LeoRibeiro01/sentinela/docs/DECISOES.md

# Registro de decisões técnicas

Cada decisão: o que foi decidido e por quê. Mais recentes no fim.

## Fases 0 e 1 — ambiente e firmware

- **Arduino CLI portátil em `.tools/`** (1.5.1, ignorado pelo Git) com core `esp32:esp32` **2.0.17** e FQBN `esp32:esp32:esp32`. O `winget` encontrou o pacote, mas não concluiu a instalação; a versão portátil evita depender de PATH/admin. Em outra máquina, basta seguir o README.
- **Rede em modo Access Point** fixo (`SENTINELA` / `sentinela123` / `192.168.4.1`), canal 6, até 4 clientes, `WiFi.setSleep(false)` e `WiFi.persistent(false)` (não grava configuração na flash a cada boot). Redes de faculdade costumam isolar dispositivos; o AP elimina essa dependência e funciona sem internet.
- **Firmware dividido em 3 arquivos**: `captura_audio.*` (amostragem), `atuadores.*` (pinos e modo auto) e `esp32_server.ino` (Wi-Fi e rotas). Um arquivo = uma responsabilidade, o que facilita a explicação na defesa.
- **Amostragem: timer de hardware + tarefa FreeRTOS no núcleo 1** (primeira opção do plano do projeto). O timer 0 usa divisor 40 (2 MHz) e alarme de 125 ticks, ou seja, **16 000 Hz exatos**. A versão anterior usava 62 µs, o que dava 16 129 Hz. A interrupção só notifica a tarefa, porque `adc1_get_raw` usa travas que não podem ser chamadas dentro de uma ISR. A tarefa tem prioridade 3 no núcleo 1 (o `loop()` tem prioridade 1); a pilha Wi-Fi fica no núcleo 0. O ADC contínuo por DMA (I2S-ADC) **não** foi adotado por causa dos relatos de leituras zeradas com Wi-Fi.
- **Medição de estabilidade**: a tarefa conta ticks perdidos (notificações acumuladas) e o maior intervalo entre amostras por segundo. Os valores aparecem em `/status` (`amostras_perdidas`, `intervalo_max_us`) e no log serial. Assim, taxa real e jitter são medidos, e não supostos.
- **Remoção de DC com média móvel em `float`** (α = 1/1024, corte de ~2,5 Hz). O filtro anterior era inteiro (`media += (x - media) >> 8`) e tem uma "zona morta" de até 255 contagens: o DC estimado parava longe do real e o resíduo inflava o RMS. Em simulação de silêncio, o RMS saía 32 em vez de 8. O ESP32 tem FPU de precisão simples, então o `float` é barato.
- **ADC1_CH6 (GPIO34), 12 bits, atenuação máxima.** No core 2.0.17 a constante `ADC_ATTEN_DB_11` está obsoleta e é idêntica a `ADC_ATTEN_DB_12`; usamos a nova para compilar sem avisos.
- **Buffer circular estático de 32 768 amostras PCM16 (64 KB, ~2,05 s).** É o limite de memória definido para a placa sem PSRAM. Por isso `/audio.wav` aceita `ms` de 200 a 2000.
- **WAV enviado em blocos de 512 bytes** com a API do `WebServer` (`setContentLength` + `sendContent`), sem copiar o trecho inteiro para a RAM. Limitação conhecida: com `ms=2000` sobram só ~48 ms de folga antes de a captura sobrescrever o início do trecho. Isso só corrompe o começo do WAV se o Wi-Fi travar o envio por mais de 48 ms logo no início. A IA usa `ms=1000` (folga de ~1 s).
- **Taxa no cabeçalho WAV = taxa medida** (`fs_real_hz`), como pede o contrato; antes da primeira medição usa 16 000.
- **Atuadores alterados só pelo `loop()`**. O modo `auto` passou da tarefa de áudio para o `loop()`, que avalia cada janela nova de 250 ms. Antes, a tarefa de áudio e os handlers HTTP mexiam no mesmo estado ao mesmo tempo (condição de corrida).
- **Modo auto com histerese**: alerta após 3 janelas acima do limiar (~0,75 s); volta a normal após 8 janelas abaixo (~2 s). Sem isso, o alerta e o buzzer piscariam a cada palavra.
- **`teste`**: sequência de 2 s (verde, vermelho, verde, vermelho, beep de 0,5 s, pausa) e depois **volta ao estado anterior**, para não atrapalhar uma demonstração em andamento.
- **Campos extras** (além do contrato, sem remover nenhum): `/status` ganhou `limiar`, `heap_minimo`, `amostras_perdidas`, `intervalo_max_us` e `clientes_wifi`; `/sensor` ganhou `adc_min`/`adc_max`, que mostram diretamente se o ADC está lendo zero com o Wi-Fi ligado (o teste crítico). A resposta de `/atuador` é `{"ok":true,"atuador":{...}}`, o mesmo objeto de `/status`.
- **`nivel`** é uma escala relativa: RMS 600 contagens = 100. Não é dB SPL. Pode ser recalibrado depois de medir silêncio e motor na placa.
- **Teste automatizado da Fase 1 em Python puro** (`tools/teste_fase1.py`, só biblioteca padrão), em vez de dezenas de `curl.exe` manuais: o resultado é objetivo ([OK]/[FALHA]) e repetível na segunda-feira.

## Fase 2 — dashboard e simulador

- **Dashboard em JS puro** (`index.html`/`app.js`/`style.css`), sem framework, CDN ou build. Abre por duplo clique (`file://`) ou servido pela IA em `localhost:5000`. Gráficos em `<canvas>` desenhados à mão, com FFT radix-2 própria para o espectro.
- **Polling sequencial** (`/status` e depois `/sensor`, a cada 1 s), porque o `WebServer` do ESP32 atende um cliente por vez. Timeout de 2 s com `AbortController`. **Duas falhas seguidas** mostram DESCONECTADO (uma só causaria pisca-pisca por perda de pacote). O laço nunca para, então a reconexão é automática.
- O áudio (forma de onda/espectro) só é baixado **sob demanda** ou a cada 5 s, se marcado, para não disputar o ESP32 com o serviço de IA.
- Endereço do ESP32: `?esp32=` na URL > `localStorage` > `192.168.4.1`. Ao mudar, o dashboard avisa o serviço de IA (`/api/config?esp32=`).
- Dados da rede entram na página só por `textContent`, nunca `innerHTML`.
- Visual para projetor: fundo escuro, fontes grandes, estado sempre em **texto e cor**.
- **Simulador `tools/mock_esp32.py`** (só biblioteca padrão), com a mesma API, as mesmas validações e a mesma lógica do atuador e do modo auto do firmware. Pode tocar WAVs reais (`--wav-dir`, `--padrao`) para testar a IA de ponta a ponta sem placa. Passa em 100% do `teste_fase1.py rotas`.

## Fase 3 — IA

- **YAMNet + regressão logística** (scikit-learn) sobre os embeddings de 1024 dimensões. Modelo pequeno (~60 KB), versionado; o YAMNet (~18 MB) é baixado uma vez por `tools/baixar_yamnet.py` e roda offline (verificado com rede bloqueada no processo de teste). O TensorFlow 2.21 instalou no Python 3.11, então o fallback MFCC + RandomForest não foi necessário.
- **Três perguntas em sequência**, pedidas pela equipe ("identificar se o som é realmente de um carro"):
  1. *Tem som?* RMS bruto contra um limiar, calibrável pelo botão "Calibrar silêncio" (o ruído real do MAX9814 com AGC só é conhecido na placa).
  2. *É carro?* Um **porteiro** treinado (`carro` × `nao_carro`) mais um **veto do YAMNet**: fala, música, animais, chuva, sirene etc. ≥ 0,5 **e** som de veículo < 0,2. O veto existe porque não há fala nem música nos dados negativos. A condição "veículo < 0,2" evita vetar motor com alguém falando por cima.
  3. *Qual o estado?* Diagnóstico em **3 classes**: `normal`, `falha_batida_pino`, `falha_ignicao`.
- **`falha_outros` não é diagnosticada.** Os originais das falhas mecânicas do amrrashed somam só ~4 min, em 29 gravações de falhas muito diferentes (rolamento, freio, direção...). Testada como 4ª classe, teve **0% de acerto** no teste. Essas gravações entram só como exemplos de "é carro" no porteiro (`classes_somente_porteiro` em `fontes.json`). Trabalho futuro.
- **Os WAVs segmentados do amrrashed estão corrompidos**: cabeçalho válido, conteúdo de **ruído branco em escala cheia** (autocorrelação ≈ 0, pico 1,0; áudio real fica entre 0,8 e 0,97). Foram descobertos porque o YAMNet "ouvia" chuva/spray em gravações de gato. A primeira versão do modelo, treinada com eles, parecia ótima (100% em `falha_outros`), mas tinha aprendido "ruído branco". Usamos as gravações originais (`.m4a`, decodificadas com o ffmpeg do pacote `imageio-ffmpeg`, só na preparação). O `prepare_dataset.py` agora **descarta automaticamente** trechos com esse padrão, o que protege também os datasets do Kaggle.
- **Ruído sintético como `nao_carro`** (branco, rosa, marrom, zumbido de 60 Hz): sem isso, um chiado poderia virar "carro com falha". No teste de ponta a ponta, um tom puro de 120 Hz passou de "normal 99%" para "não é carro".
- **Divisão por gravação** (grupo) em 70/15/15. Para o kwerimoto, usamos o split do autor, que já separa por vídeo. **C** e **limiar de confiança** são escolhidos na **validação**; o teste só é usado no relatório final.
- **Pesos**: cada classe pesa igual. Dentro da classe, cada fonte pesa pela **raiz quadrada** do seu tamanho. Com peso igual por fonte, 1 trecho isolado de uma fonte passava a valer o mesmo que 76 de outra.
- **Só quadros cheios do YAMNet**: ele completa o fim do áudio com zeros e cria um quadro parcial. Com 1 s de áudio, metade dos quadros era "meio silêncio", e isso derrubava a confiança ao vivo (saudável saía 42–47% → inconclusivo). Depois da correção, 17 de 18 diagnósticos de ponta a ponta acertaram; o 18º deu "inconclusivo".
- **Diagnóstico de 5 s**: as janelas de 1 s com som são **concatenadas** e analisadas juntas (~9 quadros), o mesmo formato da métrica "simulação do botão DIAGNOSTICAR". **Ao vivo**: ver Rodada 2 (memória de 5 s).
- **Suavização ao vivo**: maioria de 3 dos últimos 5 votos *confiantes*. Silêncio, "não é carro" e votos incertos não mudam o estado, o que dá histerese natural. O `/atuador` só é chamado quando o estado muda. A opção "IA comanda os LEDs" vem **desligada** por padrão, para não brigar com os botões manuais. No simulador, foram 60 s de silêncio com a opção ligada: 0 alertas.
- **Aumento de dados**: uma cópia de cada trecho de treino com passa-faixa 150–6000 Hz e ruído (SNR 15–30 dB). Avaliação de robustez **separada** e mais dura: 250–5000 Hz, SNR 12 dB, saturação e 12 bits. Ela derruba a acurácia de ~79% para ~72%.
- **Servidor com `http.server`** da biblioteca padrão (sem Flask): menos dependências e menos coisas para explicar. Uma trava garante que o serviço nunca faz dois pedidos simultâneos ao ESP32.
- **Base de conhecimento** (`diagnosticos.json`): texto conservador, sempre com o aviso "apoio à decisão, não substitui um mecânico". **A equipe deve revisar.**

## Rodada 2 da IA (09/11) — mais dados, encontrados pela equipe

- **MyDataSet** (Hugging Face, gravações de celular): adicionadas **`falha_correia`** (59 arquivos) e **`falha_tucho`** (68). As partes `healthy`/`misfire` desse dataset não foram usadas, porque já estão dentro do kwerimoto (duplicação entre treino e teste).
- **ESC-50** (CC BY-NC): 1755 trechos de sons ambientais como `nao_carro`, agrupados pelo clipe de origem. Ficaram de fora as categorias ambíguas (motor, buzina, trem, avião, helicóptero, motosserra). O porteiro agora é avaliado também contra sons de sala (palmas, risada, teclado, batida em porta...).
- **OtoMobile** avaliado e descartado: 65 gravações para 12 falhas (~5 por classe). **Kaggle** não foi usado: exige login.
- **Aumento de dados com a cadeia de captura**: a cópia de treino agora sorteia a faixa do alto-falante (100–300 Hz a 4–7 kHz), o ruído (SNR 10–30 dB) e, com 50% de chance cada, saturação e quantização de 12 bits. O teste de robustez continua com parâmetros **fixos** e só em trechos de teste. Com isso, a aceitação do porteiro em áudio degradado foi de 79% para 82% e o diagnóstico degradado de 71% para 73%.
- **Comparação antes de trocar o modelo**: só aceitamos o modelo novo porque ele não piorou nas métricas que importam para a demo (ver tabela no histórico de commits). O modelo anterior está na tag `v1.0-pre-montagem`.
- **Kit de demonstração** (`tools/montar_sons_demo.py`): trechos de teste que o pipeline acerta em **qualquer** janela de 5 s. A primeira versão validava só os 5 s iniciais e falhou no tucho (inconclusivo); depois da correção, acertou 24 de 24 no simulador. Na apresentação, dizer que são exemplos escolhidos; as métricas honestas são as do `metricas_ia.md`.
- **Modo ao vivo com memória de 5 s**: analisar só 1–1,5 s por vez fazia o resultado oscilar. Tocando knock, o painel alternava entre "batida", "normal" e "fala", e a decisão estabilizada chegou a ficar em NORMAL. Agora o serviço guarda as últimas 5 janelas de 1 s e analisa tudo junto a cada segundo (mesmo formato do botão). Silêncio, erro de rede, diagnóstico ou troca de ESP32 zeram a memória. No simulador, as 6 classes do kit deram 12 de 12 leituras corretas ao vivo.
- **Bug corrigido — alerta antigo reenviado**: a decisão estabilizada ficava guardada. Ao ligar "IA comanda os LEDs" depois de um alerta antigo, o LED vermelho acendia mesmo em silêncio (59 de 60 leituras no teste). Agora ligar/desligar a opção ou trocar de ESP32 zera a decisão. Reteste no mesmo cenário: 0 de 60.
- **Mensagem "não é carro"**: o nome do som só aparece quando o YAMNet o reconheceu claramente (veto). Antes podia sair "não é motor de carro (veículo)".

## Rodada 3 da IA (09/11, noite) — 10 classes com áudio do YouTube: testada e REPROVADA

- **Pedido da equipe:** mais diagnósticos (junta homocinética, pivô, pastilha de freio, amortecedor, pistão; correia, pino e balancim/válvula já existiam — balancim entra em `falha_tucho`, mesmo "tec-tec").
- **Fonte:** os datasets públicos têm 1 gravação por falha de suspensão/freio (amrrashed) e os demais exigem login (Kaggle, Freesound). A equipe autorizou usar áudio de vídeos do YouTube (uso acadêmico, sem redistribuir; `data/` não é versionado). `tools/baixar_youtube.py` busca, filtra pelo título, baixa só o áudio e remove fala/música com o YAMNet. Resultado: 11–14 vídeos por classe, 3,8–9,4 min úteis; 6 vídeos reprovados na conferência manual (motos, "no piston slap", freio sem o som).
- **Resultado do candidato de 10 classes (teste por vídeo):** acurácia do diagnóstico 48,7% (atual: 81,7%); motor normal reconhecido 67% (atual: 88%, ou seja, mais alarmes falsos); batida de pino 51% (atual: 71%); porteiro 90% (atual: 93%). Classes novas: amortecedor 0%, pistão 7%, homocinética 11%, freio 18%, pivô 50%. Até as classes antigas pioraram nos trechos do YouTube (correia 11%, pino 7%).
- **Por que falhou:** cada vídeo tem carro, microfone, edição e ruído de rua diferentes, e há só ~10 vídeos por classe; o modelo aprende "o jeito do vídeo", não a falha. Os conjuntos de teste das classes novas têm só 2 vídeos cada, então nem a métrica é confiável. Além disso, homocinética, pivô, freio e amortecedor só fazem barulho com o carro **em movimento**, longe do microfone que fica no motor.
- **Decisão:** manter o modelo de 5 classes (`models/` intacto). A fonte ficou em `fontes_desativadas` no `fontes.json` (o `prepare_dataset.py` a ignora), para quem quiser repetir o experimento. As fichas das falhas novas ficaram em `diagnosticos.json` como base de conhecimento para trabalho futuro.
- **Trabalho futuro:** gravar as falhas com o próprio SENTINELA em carros reais (várias gravações por falha), e um segundo microfone perto das rodas para os ruídos de suspensão e freio.

## Regulamento V1.2 (10/11) — o que mudou e por quê

- **Regulamento novo**: além do servidor, pede que a placa *se conecte a uma rede Wi-Fi* e se reconecte registrando data e hora; log persistente na flash com ERRO/AVISO/INFO; IP e MAC disponíveis; atuador que **não seja LED nem buzzer**; relatório ABNT com 5 projetos semelhantes; repositório público no GitHub. Checklist completo em `docs/CHECKLIST_TDE.md`.
- **Wi-Fi AP+STA** (não só AP, não só estação): a estação atende o requisito (rede real, DHCP, reconexão); o AP `SENTINELA` continua como plano B para nunca ficar sem acesso. A rede da estação é configurada pela rota `/wifi` e guardada na NVS, para trocar de rede no dia sem recompilar. Reconexão própria a cada 15 s (a automática do SDK foi desligada para registrar cada etapa). Rede recomendada na apresentação: hotspot de celular (eduroam exige login 802.1X, que não foi implementado).
- **Log em LittleFS com fila**: `registrar()` só enfileira (pode ser chamado de qualquer tarefa, inclusive do callback de Wi-Fi); a tarefa principal é a única que escreve na flash. Rotação em 48 KB (dois arquivos). Data/hora por NTP ou pelo navegador (`/relogio`); eventos do boot esperam até 90 s e recebem a hora corrigida retroativamente. Só eventos são registrados (não leituras periódicas), porque a escrita na flash pausa o cache e pode custar algumas amostras de áudio.
- **Tela OLED SSD1306 como atuador** (Adafruit SSD1306 2.5.13 + GFX 1.13.0): tarefa própria no núcleo 0 a 4 Hz (um quadro leva ~25 ms no I2C e não pode atrasar o HTTP); detecção automática em 0x3C/0x3D a cada 3 s, para o firmware funcionar sem a tela e reconhecê-la depois. O texto da falha chega por `/atuador?...&falha=` (máx. 40 bytes, sem aspas/barras, porque vai para o JSON) e os acentos são trocados por letras simples (a fonte não os tem).
- **Dashboard servido pela placa**: exigência relatada pela turma ("a página não pode ser acessada com o ESP desligado"). `tools/gerar_pagina_esp32.py` embute HTML+CSS+JS num único arquivo gzip (~17 KB) em `pagina_web.h`; a rota `/` o envia com `no-store`. Com a placa caída, o JS esconde a interface inteira; quando volta, recarrega a página pela placa. O serviço de IA deixou de servir o dashboard (agora redireciona para a placa) e responde ao pré-teste de rede local do Chrome (`Access-Control-Allow-Private-Network`).
- **Animações sem "fill-mode both"**: no teste, cartões ficaram invisíveis quando a animação de entrada atrasou. Animação que esconde conteúdo até rodar não vale o risco numa demo; agora, se não rodar, o conteúdo aparece direto.
- **Evidências automatizadas** (`tools/coletar_evidencias.ps1`): ping, ARP, porta 80 × 81, socket TCP escrito à mão (no lugar do telnet, que não vem no Windows), `curl -v`, atuadores, erros e log, salvos em `docs/evidencias/<data>/`.
- **Relatório ABNT** em Markdown (`docs/RELATORIO_TDE.md`) + gerador de `.docx` formatado (`tools/gerar_relatorio_docx.py`, usa `python-docx`, só ferramenta de documentação). Os 6 projetos semelhantes foram conferidos nas páginas originais (diagrama, código e bibliotecas); um candidato (Edge Impulse) foi descartado porque a página não existe mais, e outro (WLED) por não ter diagrama.

## Ajustes medidos na placa com o OLED (12/11)

- **Boot de ~29 s → 0,34 s.** Medindo cada etapa na Serial (`[boot] ...`), a lentidão não era o log: depois que a captura de áudio começa (núcleo 1, prioridade 3, 16 kHz), o restante do `setup()` — que também roda no núcleo 1 — quase não recebe CPU; iniciar a tela depois da captura levou 25 s. Agora a captura é a **última** etapa do `setup()`, e a montagem do LittleFS também vem depois da rede e do servidor (os eventos do boot esperam na fila).
- **I2C iniciado na tarefa da tela (núcleo 0).** A interrupção do driver I2C fica no núcleo de quem chama `Wire.begin()`; no `setup()` ela caía no núcleo da captura. Depois da mudança, a perda de amostras deixou de ser contínua: restam rajadas de ~64 amostras (4 ms) a cada 15–20 s **apenas enquanto a estação tenta reconectar** a uma rede ausente (≈0,03% do áudio).
- **Dashboard lê o log a cada 15 s (50 linhas)**, não mais a cada 5 s: ler a flash pausa o cache e, com ele, a captura.
- **Microfone sem alimentação após remontagem**: `adc=[0..0]` constante = OUT em 0 V = VDD solto (com GND solto a leitura iria para cima). O jumper do VDD estava no pino GAIN; corrigido pela equipe (GAIN também em 3V3, ganho de 40 dB).
- **Log grava cada evento na hora (12/11).** A versão anterior segurava os eventos até 90 s esperando o relógio; os boots #9 a #17 (reinícios rápidos durante os testes) sumiram do log. Agora nenhum evento espera: antes do ajuste a linha sai como `sem hora (+Ns)` e, quando a hora chega, uma linha de referência informa a que horas o boot começou. As gravações também foram espalhadas (até 4 linhas por volta). Ainda há ~1600 amostras perdidas nos 10 s iniciais de cada boot (≈0,1 s de áudio), por causa das primeiras escritas na flash.
- **Buzzer só dá bipe curto (13/11).** Na placa, o modo automático entrou em ALERTA com o barulho da sala e o buzzer apitou sem parar (parecia ligado às quedas do hotspot, que aconteceram na mesma hora). Pedido da equipe: o alerta não apita; o buzzer dá só um **apito leve de 150 ms** quando o diagnóstico da IA termina (`/atuador?...&bip=1`). O aviso de alerta fica no LED vermelho e na tela OLED. `buzzer=0|1` foi mantido na API por compatibilidade.
