LeoRibeiro01/sentinela/src/esp32/esp32_server/pagina_web.h

// pagina_web.h — GERADO por tools/gerar_pagina_esp32.py. NÃO edite à mão:
// mude src/client/ e rode o gerador de novo.
// Dashboard completo (HTML+CSS+JS), gzip: 56840 -> 17160 bytes.
#pragma once
#include <Arduino.h>

const size_t PAGINA_GZ_TAM = 17160;
const uint8_t PAGINA_GZ[] PROGMEM = {
  0x1f, 0x8b, 0x08, 0x00, 0x00, 0x00, 0x00, 0x00, 0x02, 0x0a, 0xdd, 0x7d, 0xcb, 0x76, 0xdc, 0x48,
  0x76, 0xe0, 0x5e, 0x5f, 0x11, 0x45, 0x49, 0x9d, 0x80, 0x2a, 0x13, 0xcc, 0x07, 0x93, 0xa4, 0x92,
  0x22, 0x65, 0x8a, 0x62, 0x75, 0xd1, 0x96, 0x44, 0x8d, 0xa8, 0xaa, 0xee, 0xb1, 0x4a, 0x2d, 0x45,
  0x26, 0x90, 0x4c, 0x94, 0x90, 0x40, 0x36, 0x80, 0x24, 0x29, 0xb1, 0xe9, 0xe3, 0x59, 0x7a, 0xed,
  0x59, 0xcd, 0x6a, 0xe4, 0x59, 0xf8, 0xd8, 0xe7, 0xf4, 0xaa, 0x8f, 0x8f, 0xcf, 0xe9, 0xa5, 0xf9,
  0x27, 0xfe, 0x92, 0xb9, 0xf7, 0xc6, 0x03, 0x11, 0x78, 0x90, 0x29, 0x55, 0x7b, 0x16, 0x53, 0x0f,
  0x29, 0x11, 0x88, 0xc7, 0x8d, 0x88, 0xfb, 0x8e, 0x7b, 0x03, 0x8f, 0xbe, 0xf1, 0x93, 0x49, 0xfe,
  0x71, 0x11, 0xb0, 0x59, 0x3e, 0x8f, 0xf6, 0xee, 0x3c, 0xfa, 0xa6, 0xd3, 0xb9, 0xc3, 0x58, 0x18,
  0xfb, 0xc1, 0x85, 0x87, 0x45, 0xec, 0x3f, 0xff, 0xfe, 0x7f, 0xb2, 0xa7, 0x3c, 0x9b, 0x8d, 0x13,
  0x9e, 0xfa, 0xcc, 0x4f, 0xd8, 0xc9, 0xe1, 0x8b, 0xd7, 0x47, 0x2f, 0x0e, 0x9f, 0xed, 0x33, 0x27,
  0xc8, 0xf2, 0x74, 0x99, 0x2f, 0x53, 0xce, 0x7c, 0xce, 0x16, 0xd7, 0x9f, 0x4f, 0xc3, 0x98, 0xbb,
  0x1e, 0xb4, 0xff, 0x6e, 0x19, 0x4f, 0xc2, 0x24, 0xe6, 0x2c, 0x99, 0x4e, 0xa3, 0x30, 0x0e, 0x46,
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
  0xdb, 0x2d, 0x2a, 0xe8, 0xa4, 0x4b, 0x98, 0x48, 0x2b, 0x38, 0x0b, 0xe2, 0xc4, 0xf7, 0x5b, 0xcc,
  0xdf, 0x6d, 0x3d, 0x1f, 0xf4, 0xd9, 0x80, 0x0d, 0x37, 0x59, 0xaf, 0xf7, 0xe3, 0xa0, 0x7b, 0x00,
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
};
