LeoRibeiro01/sentinela/(commit log)

2026-11-06 feat: fase 1 firmware ESP32 e API acústica
2026-11-06 fix: corrige filtro de DC, taxa exata de 16 kHz e corrida no modo auto
    Divide o firmware em captura_audio, atuadores e servidor; mede amostras
    perdidas e jitter; envia o WAV pela API do WebServer; adiciona log de saude.
    [atuadores.cpp, atuadores.h, captura_audio.cpp, captura_audio.h, esp32_server.ino]
2026-11-06 feat: adiciona teste automatico de aceitacao da fase 1
2026-11-09 feat: dashboard offline em JS puro e simulador do ESP32
2026-11-09 feat: IA com porteiro (e carro?), diagnostico em 3 classes e servico local
    - prepare_dataset: fontes.json, divisao por gravacao, filtro de arquivos
    corrompidos (WAVs segmentados do amrrashed sao ruido branco), m4a via
    ffmpeg e ruido sintetico como nao_carro
    - train: embeddings YAMNet + regressao logistica, pesos por classe e fonte,
    C e limiar escolhidos na validacao, metricas por fonte e com audio degradado
    - server: ao vivo com suavizacao 3 de 5, diagnostico de 5 s, calibracao de
    silencio, modo demo e dashboard em localhost:5000
    - record: gravacao rotulada a partir do ESP32
2026-11-09 fix: layout do dashboard para projetor e altura fixa dos graficos
2026-11-09 feat: IA com 5 classes (correia e tucho), ESC-50 como nao_carro e demo mais robusta
    - novos dados: MyDataSet (correia, tucho) e ESC-50 (sons de sala como nao_carro)
    - aumento de dados imitando alto-falante + MAX9814 + ADC de 12 bits
    - modo ao vivo analisa os ultimos 5 s (antes oscilava a cada segundo)
    - fix: alerta antigo era reenviado ao ligar 'IA comanda os LEDs' em silencio
    - kit de sons de demonstracao validado em qualquer janela de 5 s
    - atalho tools/iniciar_ia.bat e decisao estabilizada no dashboard
2026-11-09 fix: HTTP lento/instavel na placa real - tarefa principal no nucleo 0
    Medido na placa: no nucleo 1 a captura a 16 kHz deixava ~22 voltas/s para o
    loop() e a maioria dos pedidos HTTP expirava (0-3 de 15). Servidor, modo auto
    e atuadores agora rodam numa tarefa no nucleo 0: 943 voltas/s, 20/20 pedidos
    em ~140 ms, teste_fase1 rotas 42/42 na placa. Tambem: ServidorRapido descarta
    conexoes paradas do Chrome apos 300 ms (antes 5 s) e /status ganhou laco_hz.
    [esp32_server.ino, servidor_rapido.h]
2026-11-10 docs: experimento de 10 classes com audio do YouTube (reprovado) e fichas das novas falhas
    Modelo de 5 classes mantido: candidato teve 48,7% x 81,7% no teste.
    Coleta reprodutivel em tools/baixar_youtube.py; fonte fica desativada.
2026-11-10 docs: ajustes de redacao
2026-11-10 feat: dashboard servido pelo ESP32, log persistente na flash, Wi-Fi AP+STA com reconexao e tela OLED
    - pagina_web.h (gerado): dashboard embutido em gzip na rota /
    - registro_log: ERRO/AVISO/INFO com data e hora em LittleFS, rota /log
    - rede: estacao Wi-Fi com reconexao registrada, AP SENTINELA de reserva, /wifi, mDNS, NTP
    - tela_oled: SSD1306 I2C mostra estado, falha, IP e hora; /atuador aceita falha=
    - /status com IP, MAC, rede, hora e boot; /relogio acerta a hora pelo navegador
    - servico de IA envia o nome da falha e redireciona / para a placa
2026-11-10 feat: script de coleta de evidencias de rede (ping, arp, porta TCP, socket, curl, atuadores, log)
2026-11-12 fix: boot de 29 s para 0,3 s (captura por ultimo), I2C no nucleo 0 e leitura do log a cada 15 s
    [esp32_server.ino, pagina_web.h, registro_log.cpp, registro_log.h, tela_oled.cpp]
2026-11-12 fix: log grava cada evento na hora (nao perde eventos de reinicios rapidos)
    [registro_log.cpp, registro_log.h]
2026-11-13 docs: evidencias de rede na placa real (18 de 18: ping, ARP, porta 80, socket TCP, rotas, atuadores, erros, log)
2026-11-13 docs: evidencia do teste de reconexao Wi-Fi com data e hora no log
2026-11-13 feat: buzzer so da bipe curto ao fim do diagnostico (alerta e modo auto nao apitam mais)
    [atuadores.cpp, atuadores.h, esp32_server.ino, pagina_web.h]
2026-11-13 docs: relatorio com evidencias da versao final e panorama completo para a apresentacao
